Ismail-Mostafa/Wireless-sensor-network/heart beat proj/SMSM2.PDF

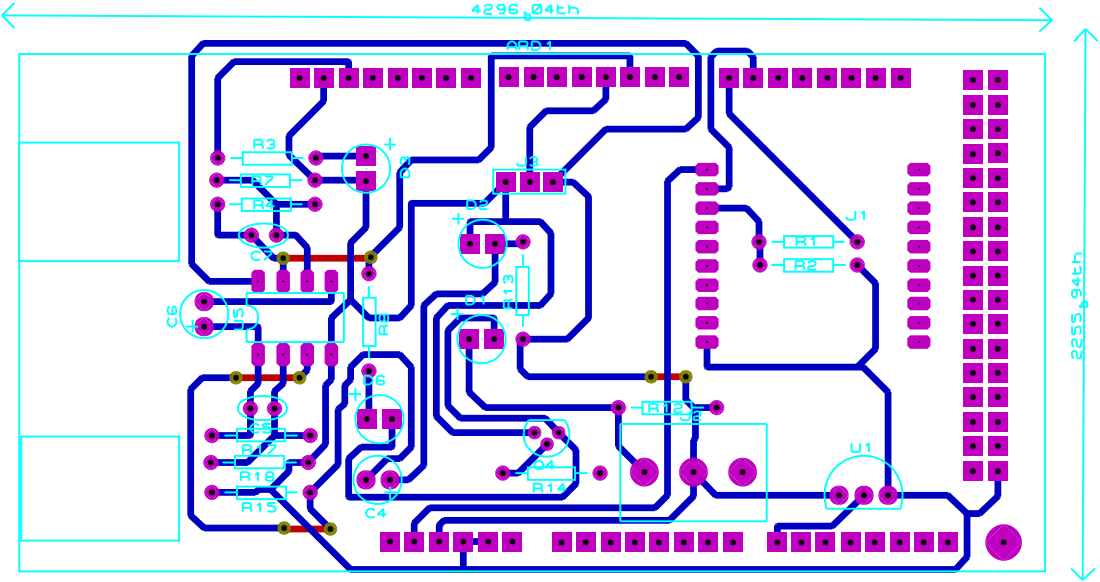
[picture p12: page 1]
