Ismail-Mostafa/Wireless-sensor-network/(list of files, drawings)

Other design files:
heart beat proj/SMSM2.DSN
heart beat proj/SMSM2.LYT
multi_sensor_test/dsn.DSN
